bikeNomad/fluke_884x_continuity_buzzer/hardware/display_board_rear.jpg

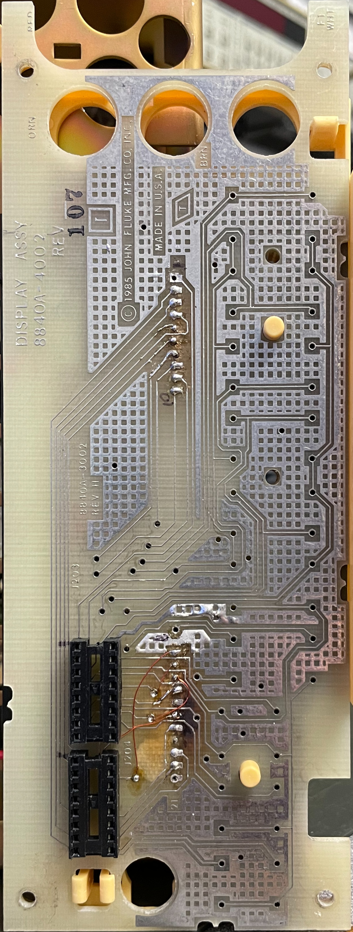
hardware/display_board_rear.jpg
