bikeNomad/fluke_884x_continuity_buzzer/board_front.png

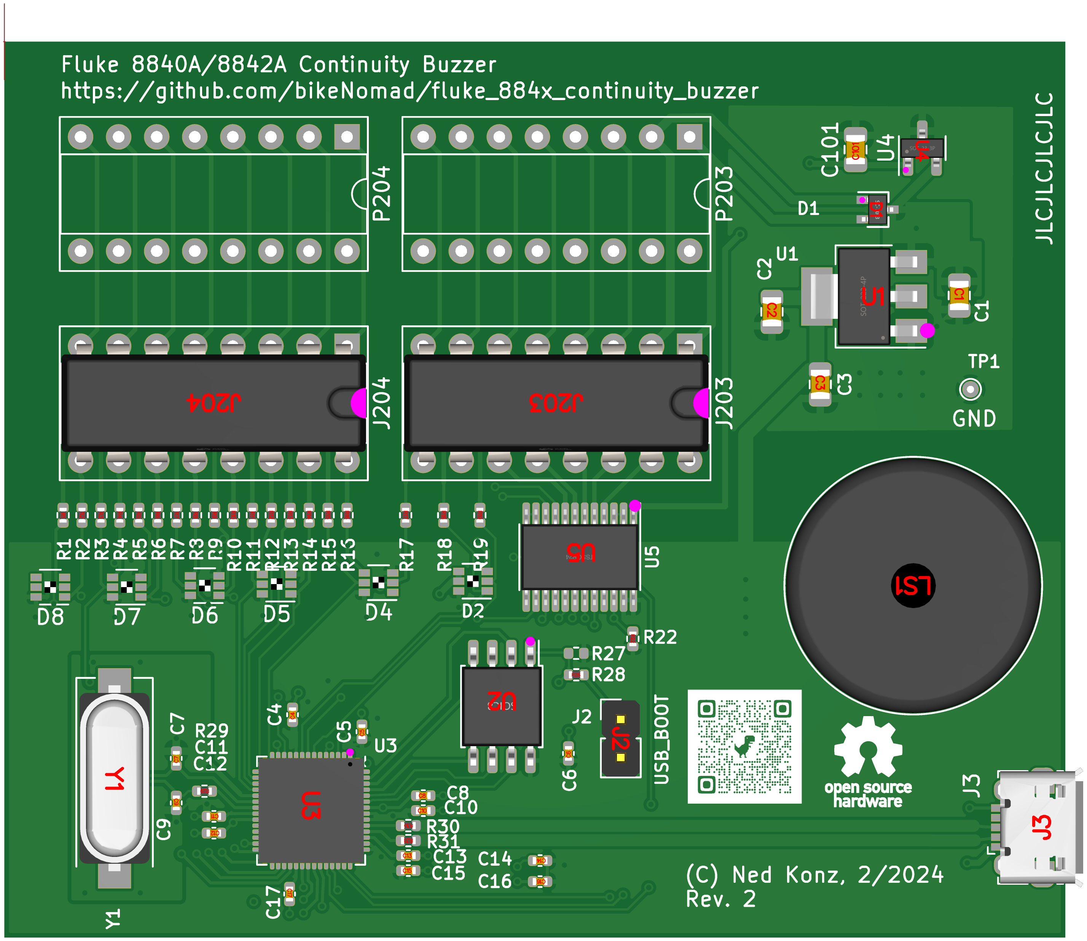
board_front.png
