bikeNomad/fluke_884x_continuity_buzzer/fluke_display_schematic.png

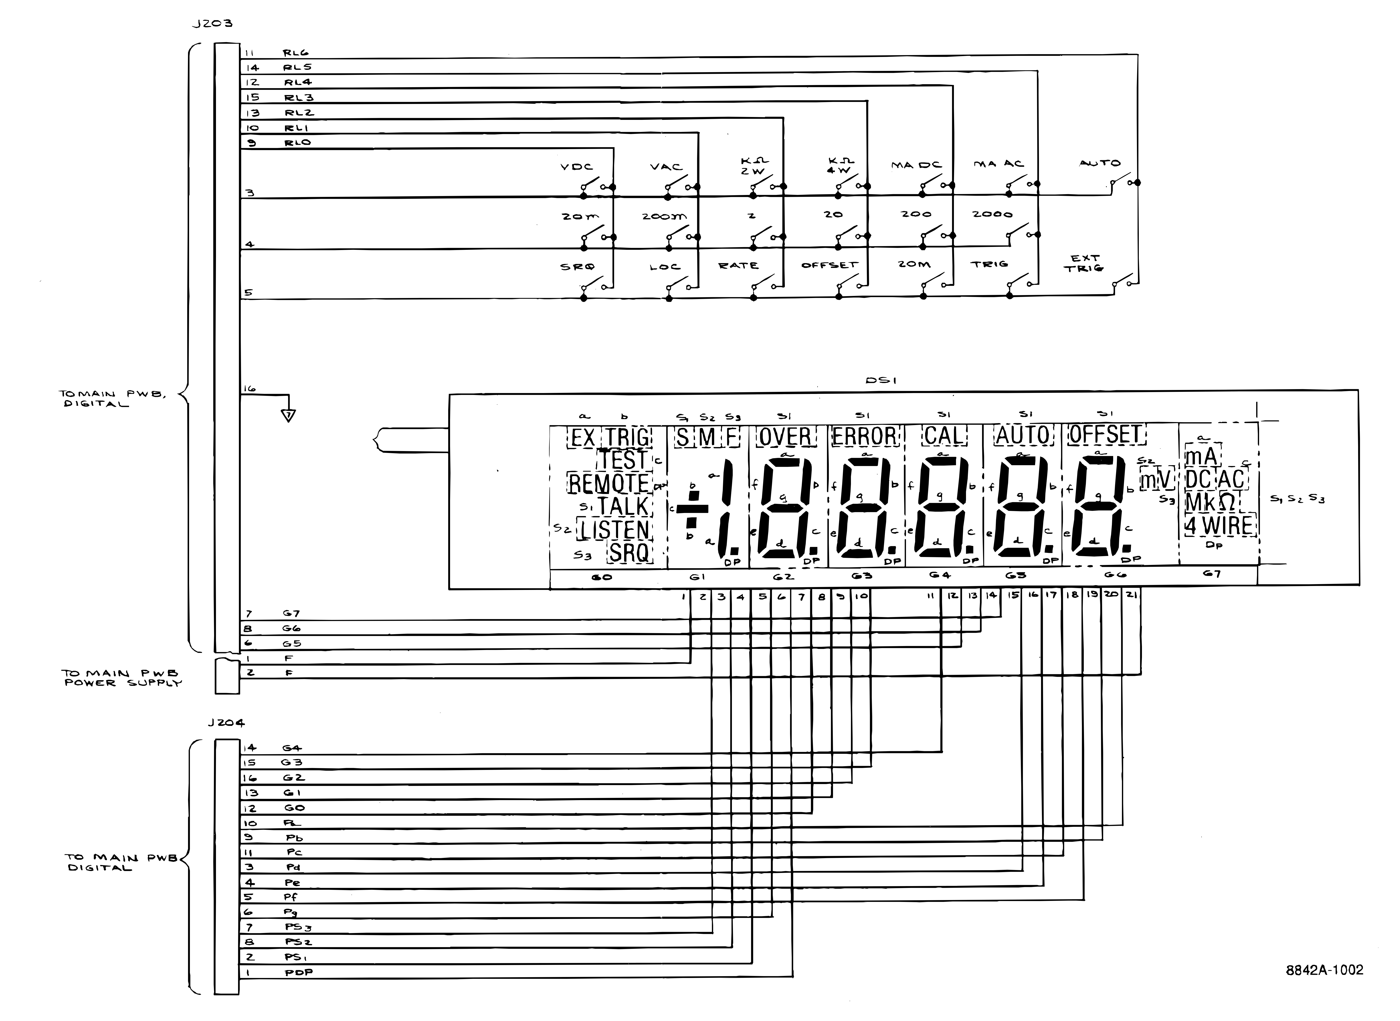
fluke_display_schematic.png
