bikeNomad/fluke_884x_continuity_buzzer/hardware/schematic.pdf

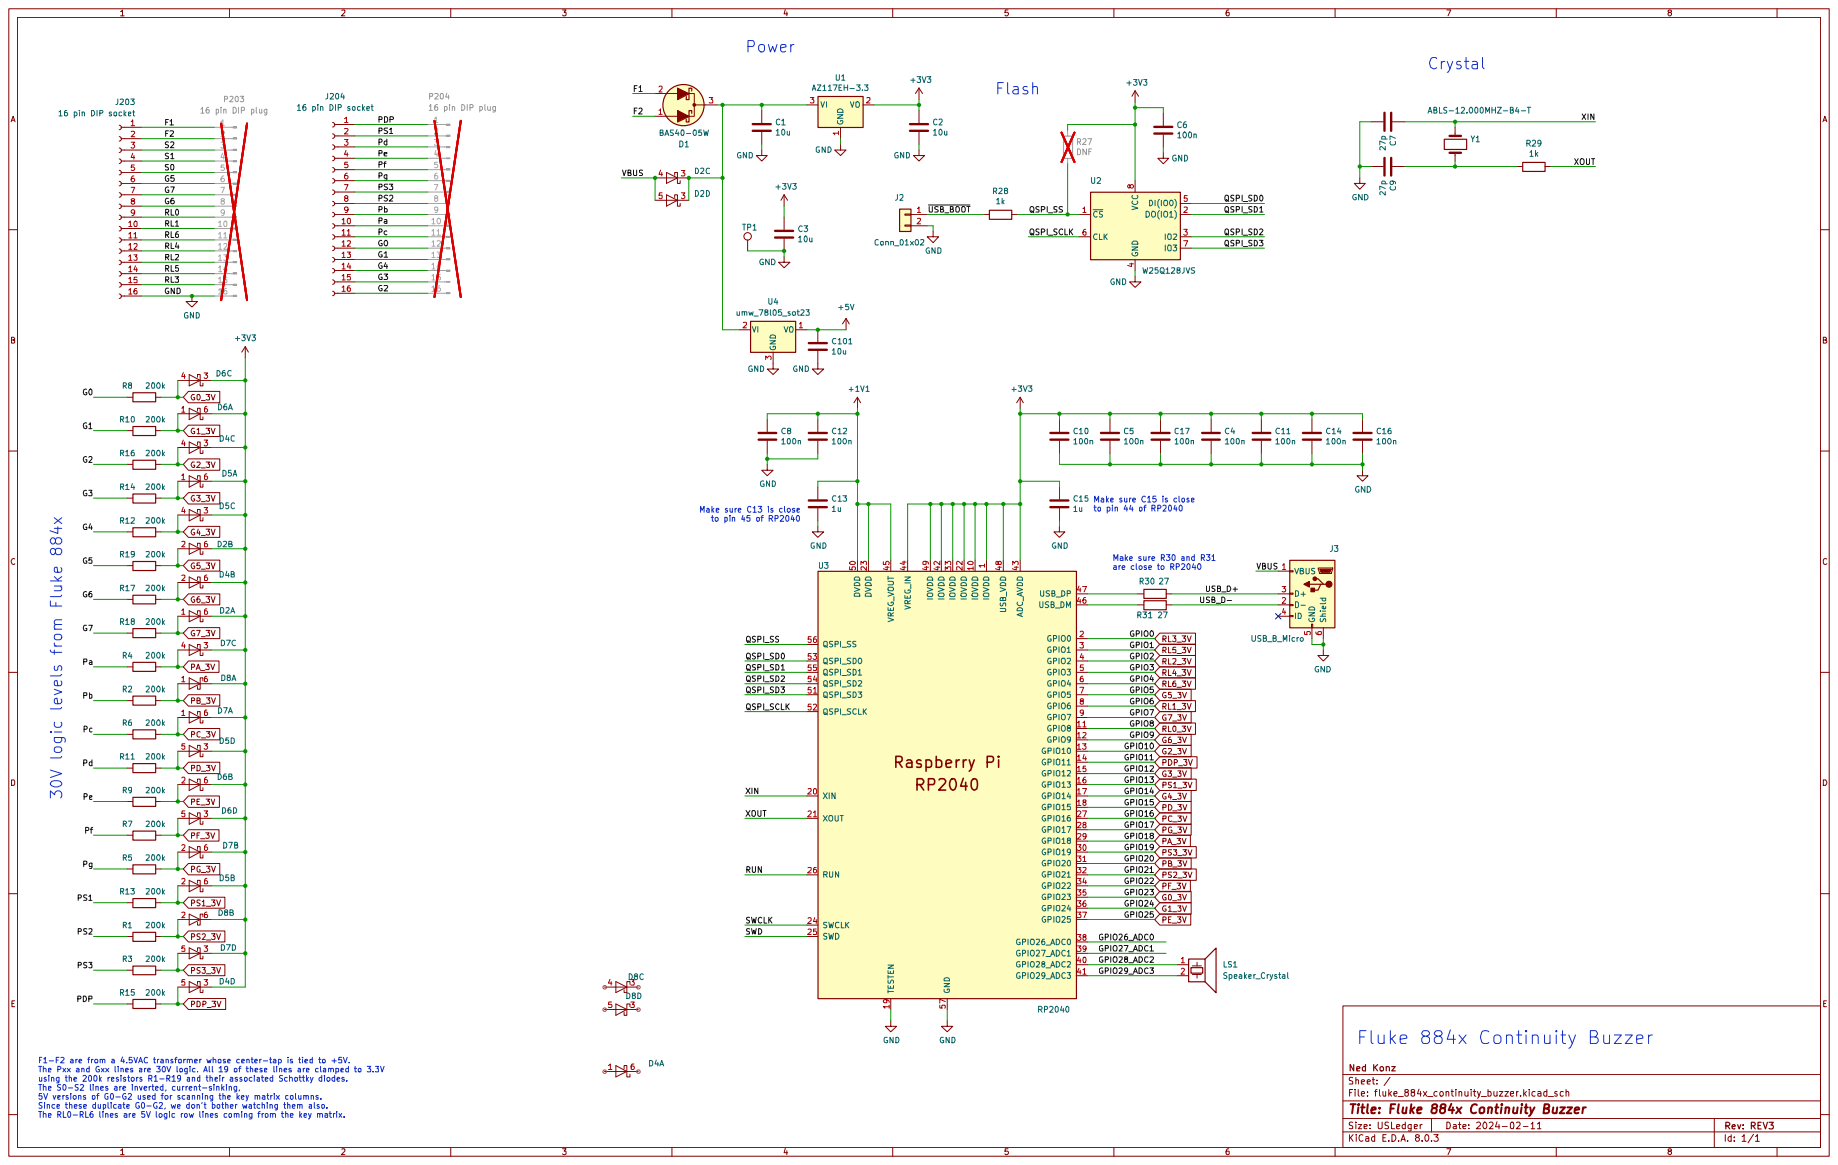
[picture p4: page 1]
