bikeNomad/fluke_884x_continuity_buzzer/hardware/fluke_884x_continuity_buzzer.kicad_pcb

## KiCad design hardware/fluke_884x_continuity_buzzer.kicad_pcb (2024-06-19)

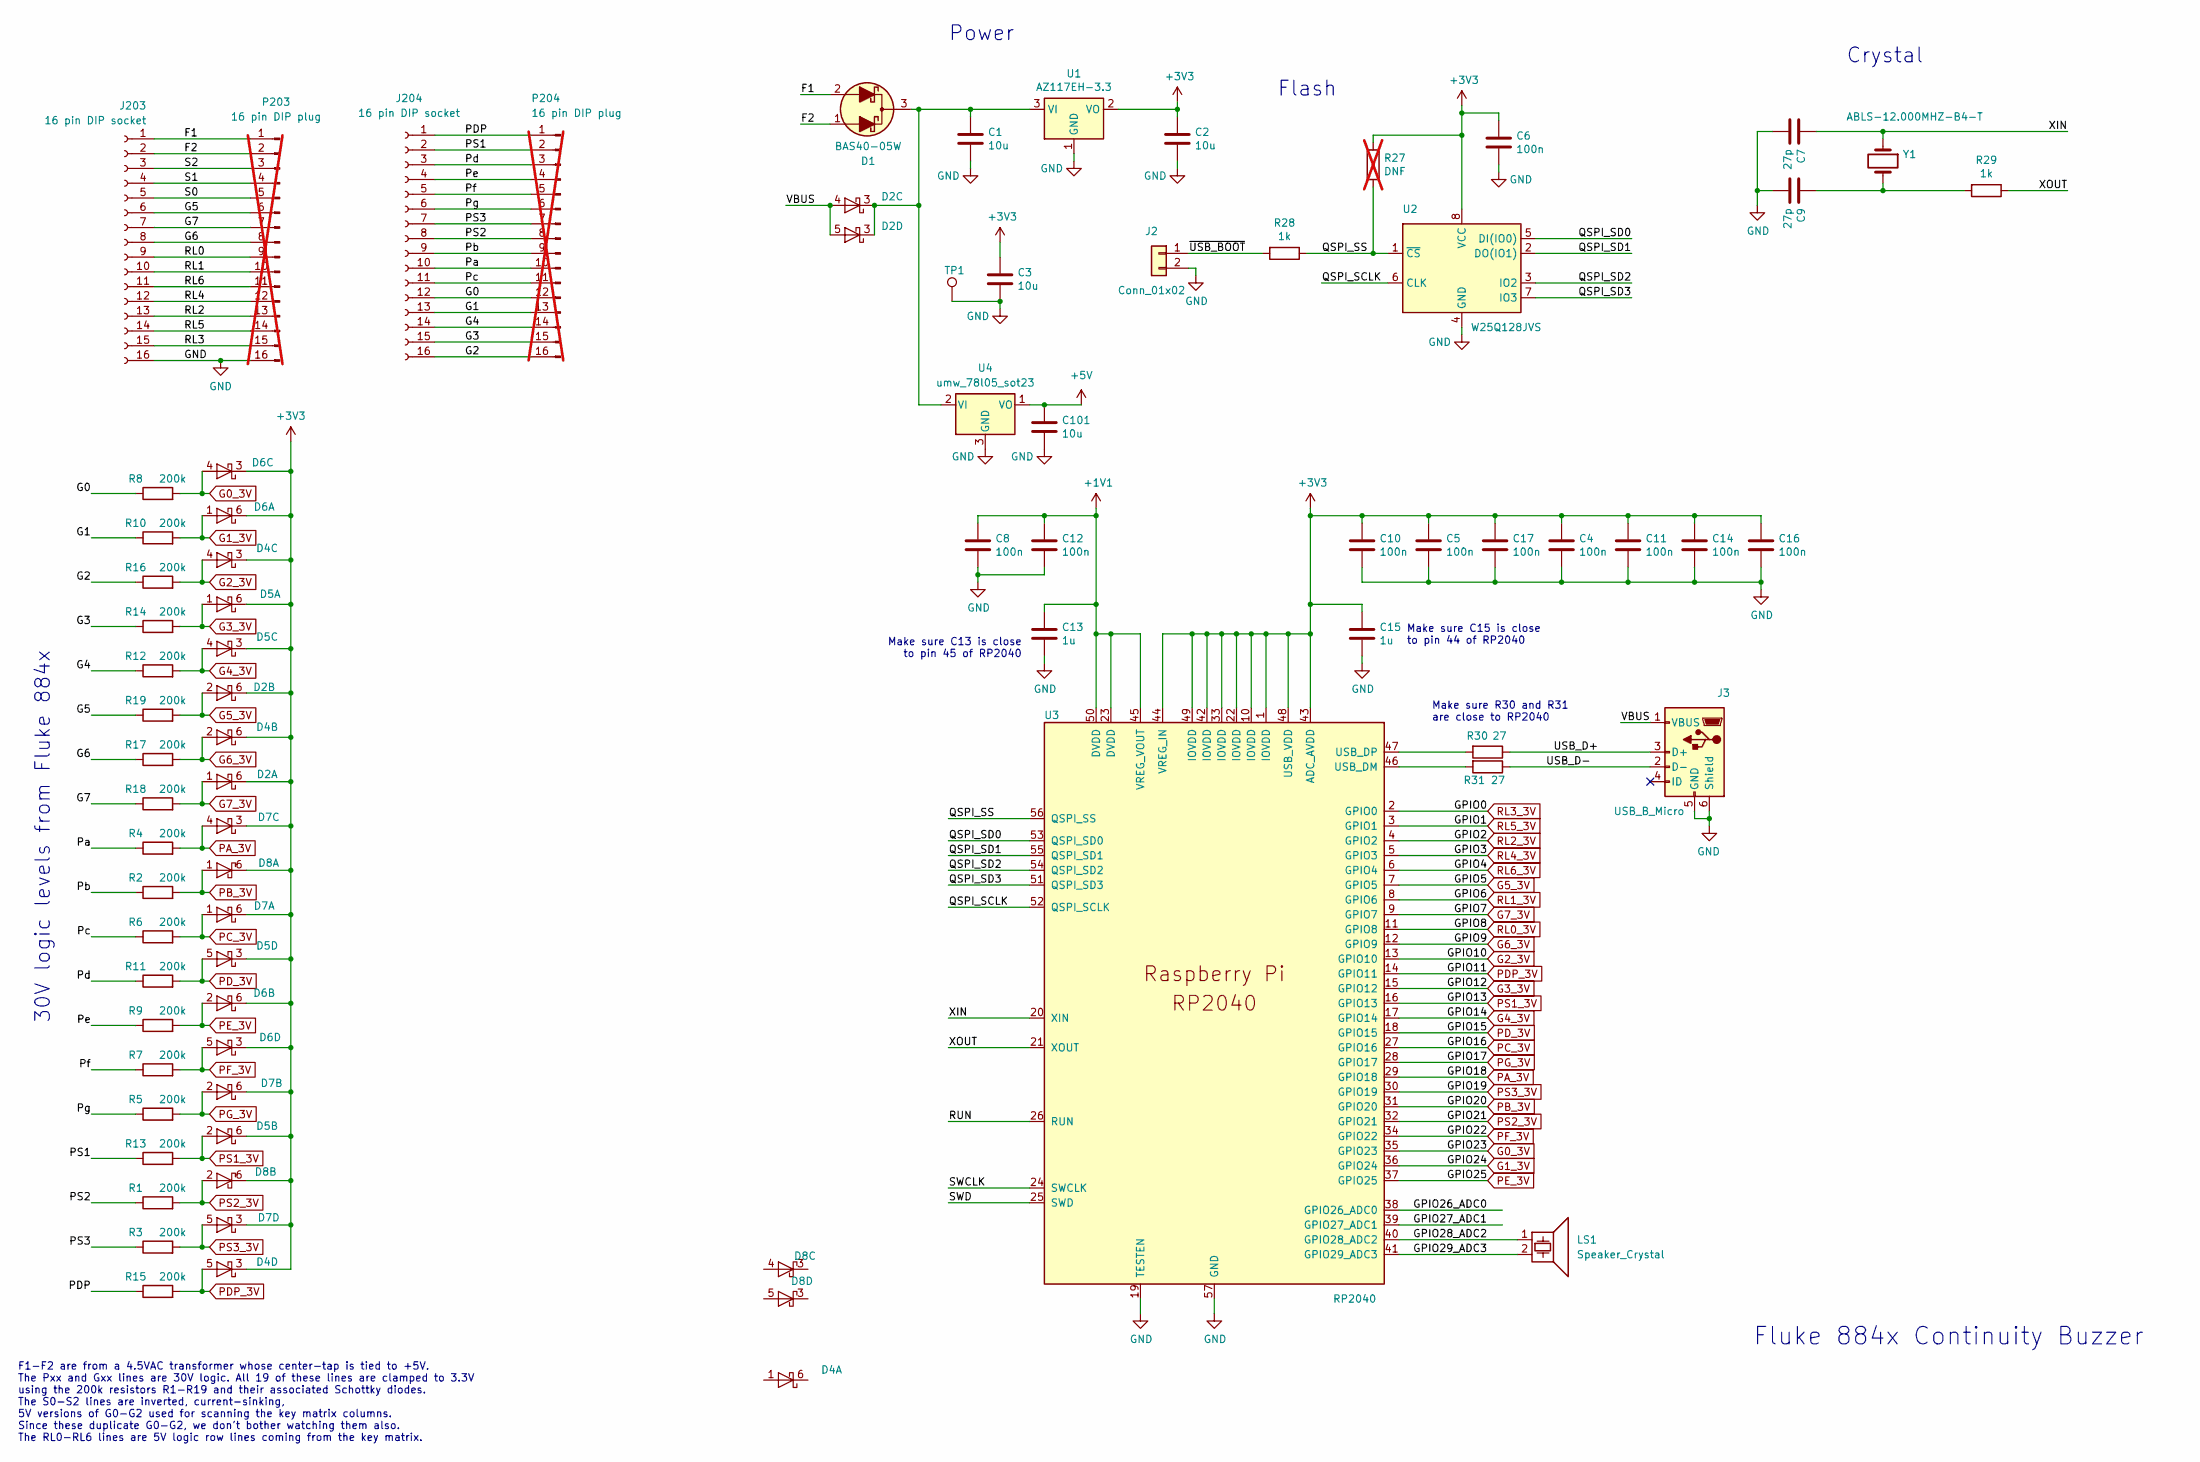
[picture p5: schematic fluke_884x_continuity_buzzer.kicad_sch, Fluke 884x Continuity Buzzer]

Parts:
C1, C2, C3, C101: 10u; C_0805_2012Metric; LCSC C15850
C4, C5, C6, C8, C10, C11, C12, C14, C16, C17: 100n; C_0402_1005Metric; LCSC C1525
C7, C9: 27p; C_0402_1005Metric; LCSC C1557
C13, C15: 1u; C_0402_1005Metric; LCSC C52923
D1: BAS40-05W; SOT-323_SC-70; LCSC C282361
D2, D4, D5, D6, D7, D8: BAT54CDW; SOT-363_SC-70-6; LCSC C5240639
J2: Conn_01x02; PinHeader_1x02_P2.54mm_Vertical; LCSC C2685154
J3: USB_B_Micro; USB_Micro-B_Amphenol_10118194_Horizontal; LCSC C132563
J203, J204: 16 pin DIP socket; DIP-16_W7.62mm_Socket; LCSC C157594
LS1: Speaker_Crystal; Buzzer_17x9RM10; LCSC C360609
P203, P204: 16 pin DIP plug; DIP-16_W7.62mm_Socket; not fitted
R1, R2, R3, R4, R5, R6, R7, R8, R9, R10, R11, R12, R13, R14, R15, R16, R17, R18, R19: 200k; R_0402_1005Metric; LCSC C25764
R27: DNF; R_0402_1005Metric; not fitted
R28, R29: 1k; R_0402_1005Metric; LCSC C11702
R30, R31: 27; R_0402_1005Metric; LCSC C25156
TP1: TestPoint; TestPoint_THTPad_D1.0mm_Drill0.5mm
U1: AZ117EH-3.3; SOT-223-3_TabPin2; LCSC C108494
U2: W25Q128JVS; SOIC-8_5.23x5.23mm_P1.27mm; LCSC C97521
U3: RP2040; RP2040-QFN-56; LCSC C2040
U4: umw_78l05_sot23; SOT-23-3
Y1: ABLS-12.000MHZ-B4-T; Crystal_SMD_HC49-US; LCSC C326543

Connections:
+1V1: C8.1, C12.1, C13.1, U3.23 (DVDD), U3.45 (VREG_VOUT), U3.50 (DVDD)
+3V3: C2.1, C3.1, C4.1, C5.1, C6.1, C10.1, C11.1, C14.1, C15.1, C16.1, C17.1, D2.6 (K), D4.3 (K), D4.6 (K), D5.3 (K), D5.6 (K), D6.3 (K), D6.6 (K), D7.3 (K), D7.6 (K), D8.6 (K), R27.1, U1.2 (VO), U2.8 (VCC), U3.1 (IOVDD), U3.10 (IOVDD), U3.22 (IOVDD), U3.33 (IOVDD), U3.42 (IOVDD), U3.43 (ADC_AVDD), U3.44 (VREG_IN), U3.48 (USB_VDD), U3.49 (IOVDD)
+5V: C101.1, U4.1 (VO)
/F1: D1.2 (A1), J203.1, P203.1
/F2: D1.1 (A2), J203.2, P203.2
/G0: J204.12, P204.12, R8.1
/G1: J204.13, P204.13, R10.1
/G2: J204.16, P204.16, R16.1
/G3: J204.15, P204.15, R14.1
/G4: J204.14, P204.14, R12.1
/G5: J203.6, P203.6, R19.1
/G6: J203.8, P203.8, R17.1
/G7: J203.7, P203.7, R18.1
/GPIO26_ADC0: U3.38 (GPIO26_ADC0)
/GPIO27_ADC1: U3.39 (GPIO27_ADC1)
/GPIO28_ADC2: LS1.1, U3.40 (GPIO28_ADC2)
/GPIO29_ADC3: LS1.2, U3.41 (GPIO29_ADC3)
/PDP: J204.1, P204.1, R15.1
/PS1: J204.2, P204.2, R13.1
/PS2: J204.8, P204.8, R1.1
/PS3: J204.7, P204.7, R3.1
/Pa: J204.10, P204.10, R4.1
/Pb: J204.9, P204.9, R2.1
/Pc: J204.11, P204.11, R6.1
/Pd: J204.3, P204.3, R11.1
/Pe: J204.4, P204.4, R9.1
/Pf: J204.5, P204.5, R7.1
/Pg: J204.6, P204.6, R5.1
/QSPI_SCLK: U2.6 (CLK), U3.52 (QSPI_SCLK)
/QSPI_SD0: U2.5 (DI(IO0)), U3.53 (QSPI_SD0)
/QSPI_SD1: U2.2 (DO(IO1)), U3.55 (QSPI_SD1)
/QSPI_SD2: U2.3 (IO2), U3.54 (QSPI_SD2)
/QSPI_SD3: U2.7 (IO3), U3.51 (QSPI_SD3)
/QSPI_SS: R27.2, R28.1, U2.1 (~CS), U3.56 (QSPI_SS)
/RL0: J203.9, P203.9
/RL1: J203.10, P203.10
/RL2: J203.13, P203.13
/RL3: J203.15, P203.15
/RL4: J203.12, P203.12
/RL5: J203.14, P203.14
/RL6: J203.11, P203.11
/RUN: U3.26 (RUN)
/S0: J203.5, P203.5
/S1: J203.4, P203.4
/S2: J203.3, P203.3
/SWCLK: U3.24 (SWCLK)
/SWD: U3.25 (SWD)
/USB_D+: J3.3 (D+), R30.1
/USB_D-: J3.2 (D-), R31.1
/VBUS: D2.4 (A), D2.5 (A), J3.1 (VBUS)
/XIN: C7.1, U3.20 (XIN), Y1.1
/XOUT: R29.1, U3.21 (XOUT)
/~USB_BOOT: J2.1, R28.2
G0_3V: D6.4 (A), R8.2, U3.35 (GPIO23)
G1_3V: D6.1 (A), R10.2, U3.36 (GPIO24)
G2_3V: D4.4 (A), R16.2, U3.13 (GPIO10)
G3_3V: D5.1 (A), R14.2, U3.15 (GPIO12)
G4_3V: D5.4 (A), R12.2, U3.17 (GPIO14)
G5_3V: D2.2 (A), R19.2, U3.7 (GPIO5)
G6_3V: D4.2 (A), R17.2, U3.12 (GPIO9)
G7_3V: D2.1 (A), R18.2, U3.9 (GPIO7)
GND: C1.2, C2.2, C3.2, C4.2, C5.2, C6.2, C7.2, C8.2, C9.2, C10.2, C11.2, C12.2, C13.2, C14.2, C15.2, C16.2, C17.2, C101.2, J2.2, J3.5 (GND), J3.6 (Shield), J203.16, P203.16, TP1.1, U1.1 (GND), U2.4 (GND), U3.19 (TESTEN), U3.57 (GND), U4.3 (GND)
unnamed: C9.1, R29.2, Y1.2
unnamed: C1.1, D1.3 (K), D2.3 (K), U1.3 (VI), U4.2 (VI)
unnamed: R31.2, U3.46 (USB_DM)
unnamed: R30.2, U3.47 (USB_DP)
PA_3V: D7.4 (A), R4.2, U3.29 (GPIO18)
PB_3V: D8.1 (A), R2.2, U3.31 (GPIO20)
PC_3V: D7.1 (A), R6.2, U3.27 (GPIO16)
PDP_3V: D4.5 (A), R15.2, U3.14 (GPIO11)
PD_3V: D5.5 (A), R11.2, U3.18 (GPIO15)
PE_3V: D6.2 (A), R9.2, U3.37 (GPIO25)
PF_3V: D6.5 (A), R7.2, U3.34 (GPIO22)
PG_3V: D7.2 (A), R5.2, U3.28 (GPIO17)
PS1_3V: D5.2 (A), R13.2, U3.16 (GPIO13)
PS2_3V: D8.2 (A), R1.2, U3.32 (GPIO21)
PS3_3V: D7.5 (A), R3.2, U3.30 (GPIO19)
RL0_3V: U3.11 (GPIO8)
RL1_3V: U3.8 (GPIO6)
RL2_3V: U3.4 (GPIO2)
RL3_3V: U3.2 (GPIO0)
RL4_3V: U3.5 (GPIO3)
RL5_3V: U3.3 (GPIO1)
RL6_3V: U3.6 (GPIO4)

Notes on the sheet:
Power
F1-F2 are from a 4.5VAC transformer whose center-tap is tied to +5V. The Pxx and Gxx lines are 30V logic. All 19 of these lines are clamped to 3.3V using the 200k resistors R1-R19 and their associated Schottky diodes. The S0-S2 lines are inverted, current-sinking, 5V versions of G0-G2 used for scan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
30V logic levels from Fluke 884x
Make sure C15 is close to pin 44 of RP2040
Make sure R30 and R31 are close to RP2040
Make sure C13 is close to pin 45 of RP2040
Fluke 884x Continuity Buzzer
Crystal
Flash

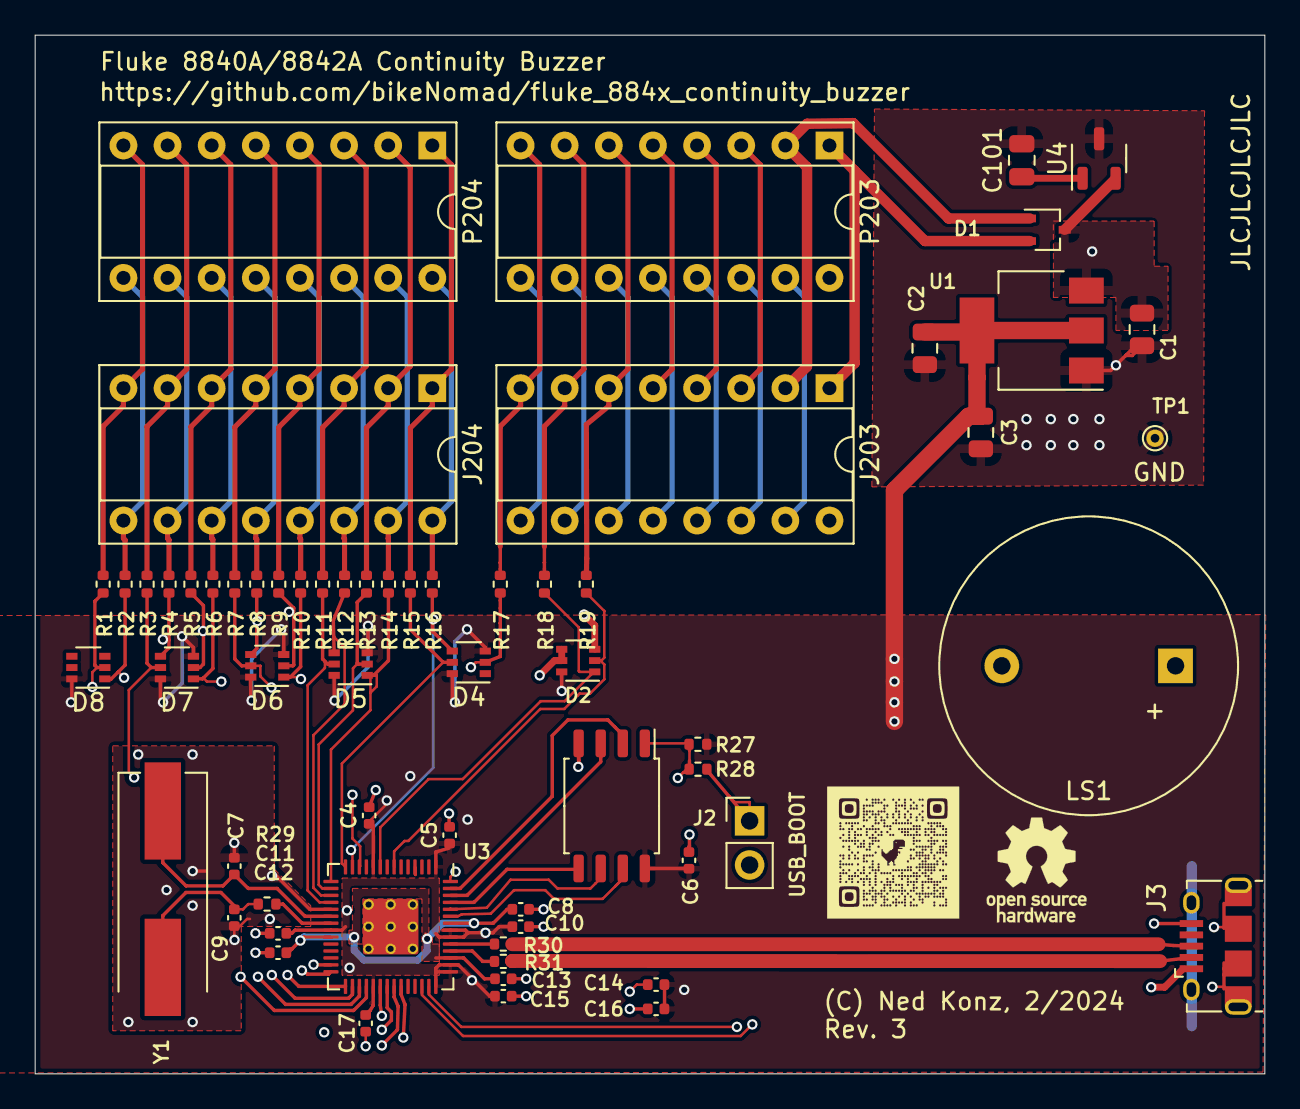
[picture p6: board fluke_884x_continuity_buzzer.kicad_pcb from above]

Board: 4 copper layers, 70.8 x 59.8 mm, 62 parts (0 on the bottom side), 72 nets.
