bikeNomad/fluke_884x_continuity_buzzer/(commit log)

2024-01-29 Added LCSC refs
    [fluke_884x_continuity_buzzer.kicad_pcb, fluke_884x_continuity_buzzer.kicad_sch]
2024-01-29 Added PDF of front of board and JLCPCB files
2024-01-30 Updated text; fixed silk
    [fluke_884x_continuity_buzzer-CuBottom.gbr, fluke_884x_continuity_buzzer-CuIn1.gbr, fluke_884x_continuity_buzzer-CuIn2.gbr, fluke_884x_continuity_buzzer-CuTop.gbr, fluke_884x_continuity_buzzer-EdgeCuts.gbr, fluke_884x_continuity_buzzer-MaskBottom.gbr, fluke_884x_continuity_buzzer-MaskTop.gbr, fluke_884x_continuity_buzzer-NPTH.drl]
2024-01-31 Moved Kicad files into hardware directory
    [fluke_884x_continuity_buzzer-CuBottom.gbr, fluke_884x_continuity_buzzer-CuIn1.gbr, fluke_884x_continuity_buzzer-CuIn2.gbr, fluke_884x_continuity_buzzer-CuTop.gbr, fluke_884x_continuity_buzzer-EdgeCuts.gbr, fluke_884x_continuity_buzzer-MaskBottom.gbr, fluke_884x_continuity_buzzer-MaskTop.gbr, fluke_884x_continuity_buzzer-NPTH.drl]
2024-02-10 WIP: made board shorter
    [fluke_884x_continuity_buzzer.kicad_pcb, fluke_884x_continuity_buzzer.kicad_sch]
2024-02-11 WIP: shortened board, added driver for keypad signals.
    Also changed 30V R values.
    [fluke_884x_continuity_buzzer.kicad_pcb, fluke_884x_continuity_buzzer.kicad_sch]
2024-02-11 Added QR code; fixed JLC refs
    [fluke_884x_continuity_buzzer-CuBottom.gbr, fluke_884x_continuity_buzzer-CuIn1.gbr, fluke_884x_continuity_buzzer-CuIn2.gbr, fluke_884x_continuity_buzzer-CuTop.gbr, fluke_884x_continuity_buzzer-EdgeCuts.gbr, fluke_884x_continuity_buzzer-MaskBottom.gbr, fluke_884x_continuity_buzzer-MaskTop.gbr, fluke_884x_continuity_buzzer-NPTH.drl]
2024-02-11 Update JLC part numbers
    [fluke_884x_continuity_buzzer-CuBottom.gbr, fluke_884x_continuity_buzzer-CuIn1.gbr, fluke_884x_continuity_buzzer-CuIn2.gbr, fluke_884x_continuity_buzzer-CuTop.gbr, fluke_884x_continuity_buzzer-EdgeCuts.gbr, fluke_884x_continuity_buzzer-MaskBottom.gbr, fluke_884x_continuity_buzzer-MaskTop.gbr, fluke_884x_continuity_buzzer-NPTH.drl]
2024-02-11 Add board image
2024-02-11 Change R1-R19 to 200k
    [fluke_884x_continuity_buzzer-CuBottom.gbr, fluke_884x_continuity_buzzer-CuIn1.gbr, fluke_884x_continuity_buzzer-CuIn2.gbr, fluke_884x_continuity_buzzer-CuTop.gbr, fluke_884x_continuity_buzzer-EdgeCuts.gbr, fluke_884x_continuity_buzzer-MaskBottom.gbr, fluke_884x_continuity_buzzer-MaskTop.gbr, fluke_884x_continuity_buzzer-NPTH.drl]
2024-02-11 Sent JLC order in
    [fluke_884x_continuity_buzzer-CuBottom.gbr, fluke_884x_continuity_buzzer-CuIn1.gbr, fluke_884x_continuity_buzzer-CuIn2.gbr, fluke_884x_continuity_buzzer-CuTop.gbr, fluke_884x_continuity_buzzer-EdgeCuts.gbr, fluke_884x_continuity_buzzer-MaskBottom.gbr, fluke_884x_continuity_buzzer-MaskTop.gbr, fluke_884x_continuity_buzzer-NPTH.drl]
2024-02-25 Add PDF of schematic.
    Also correct text in schematic.
    [fluke_884x_continuity_buzzer.kicad_sch]
2024-02-25 Add display board photo
2024-06-19 Removed bus buffer
    [fluke_884x_continuity_buzzer.kicad_pcb, fluke_884x_continuity_buzzer.kicad_sch]
